AlejandroSobral/Proyecto-EA3/README.md

# UTN.FRBA - EA3 - 2021.
### Proyecto-EA3

- Gavegno, Sebastián
- Morandi, Pablo
- Scarini, Diego
- Sobral, Alejandro
