AlejandroSobral/Proyecto-EA3/Informe/Informe_Funcionamiento_Grupo_A_v1_notas.pdf

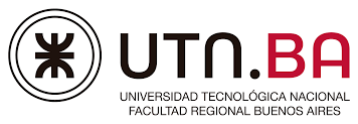
[picture p19: figure]

# Informe de Funcionamiento

## Proyecto: VCO (Voltage Controlled Oscillator)

## Materia: Electrónica Aplicada III

## Curso: R5053

## Grupo : A

## Integrantes del grupo:

### - Gavegno, Sebastián - Morandi, Pablo - Scarini, Juan Diego - Sobral, Alejandro

## Año : 2021

Electrónica Aplicada 3 - Informe de funcionamiento VCO (Voltage Controlled Oscillator) 2021

## Índice

- Índice | (pág. 2)
- Introducción | (pág. 3)
- Fundamentos teóricos del proyecto | (pág. 4)
- Cálculos y verificaciones | (pág. 8)
- Conclusiones | (pág. 22)
- Bibliografía | (pág. 23)

## Introducción:

La presentación de este informe de funcionamiento tiene como objetivo dar a conocer los fundamentos teóricos del funcionamiento del circuito, y sus posibles aplicaciones. El trabajo consiste en armar un circuito oscilador con FOL = 900 Mhz; utilizando un circuito integrado MAX2620. Las aplicaciones típicas del mismo abarcan telefonía celular, diversas aplicaciones en equipamientos de comunicaciones, entre otros.

## Fundamentos teóricos del proyecto

Para explicar el funcionamiento teórico del oscilador, comenzaremos con una analogía.
Es posible asimilar un oscilador a un circuito RLC paralelo. Para explicarlo, calculamos la respuesta libre del circuito en cuestión:

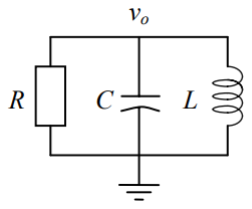
[picture p20: figure]

Si resolvemos la ecuación característica asociada, encontramos el valor de sus raíces como:

De donde podemos obtener que la condición para oscilación que estamos buscando, resulta cuando:

Del resultado anterior se deduce que un oscilador puede entenderse como un circuito LC asociado con una resistencia negativa. Al menos para entenderlo como condición necesaria de arranque. Dicha resistencia es necesaria para compensar la energía disipada en las resistencias parásitas del condensador y la bobina. Si fuera un circuito con Q ->∞, oscilaría a la frecuencia natural del par LC, y arrancaría por ruido.

Para lograr la mencionada condición de arranque, se plantea el la siguiente situación:

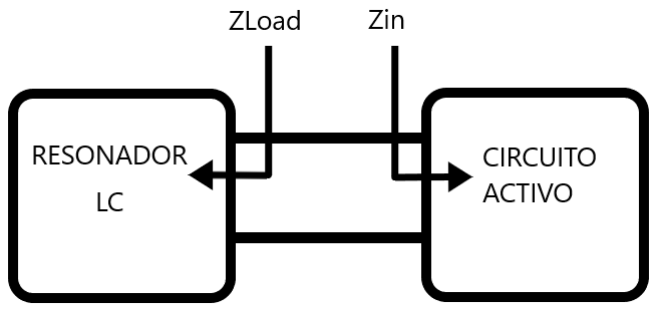
[picture p21: figure]

Dos bloques, uno determina la frecuencia, el resonador tanque LC y el otro es el circuito activo que mantiene la amplitud, mediante una resistencia negativa. Para entender este modelo suponemos que el resonador es un simple tanque junto con sus resistencias parásitas. Además, sabemos que el tanque por sí solo no puede oscilar indefinidamente porque una parte de la energía almacenada es disipada en la resistencia parásita en cada ciclo. La idea es que una red activa genere una impedancia negativa de la misma magnitud (de la misma magnitud en régmen) de la resistencia parásita. De manera resumida, se puede decir que la energía perdida por la resistencia parásita es restablecida por el circuito activo en cada ciclo, permitiendo una oscilación estable. Este modelo es llamado modelo de resistencia negativa porque la energía restaurada puede ser vista como una resistencia negativa que compensa la resistencia parásita del circuito tanque.

Un ejemplo de circuito que implementa este modelo, es la topología Colpitt common colector que figura a continuación, muy utilizada para VCO’s:

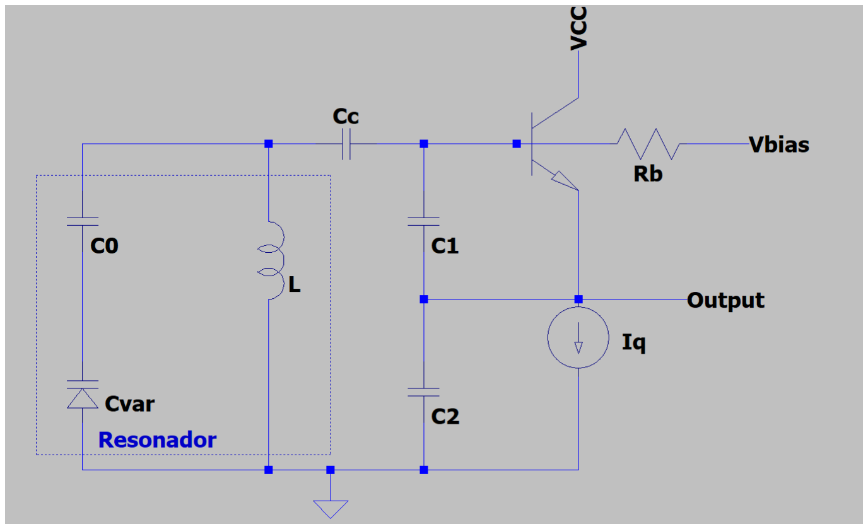
[picture p22: figure]

Este es el tipo de oscilador que el MAX2620 emplea, según la hoja de datos:

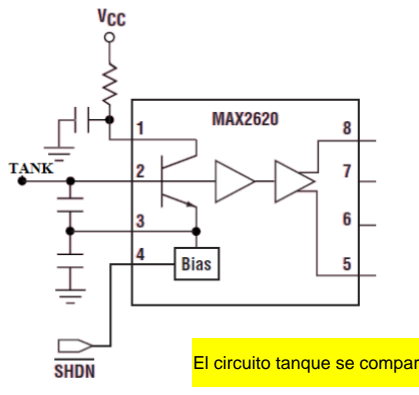
[picture p23: figure]

El circuito tanque es un circuito resonante paralelo que controla la frecuencia de oscilación variando el capacitor Cvar, para este caso.

Se pueden utilizar diodos varactores en el circuito resonante para crear un oscilador controlado por tensión (VCO).

El oscilador es en general un lazo amplificador realimentado, y las expresiones para obtener las frecuencias exactas se obtienen de las impedancias del modelo. Desde este punto de vista se plantea el modelo con una impedancia negativa y un acople que la elimina, esto se ve en la figura:

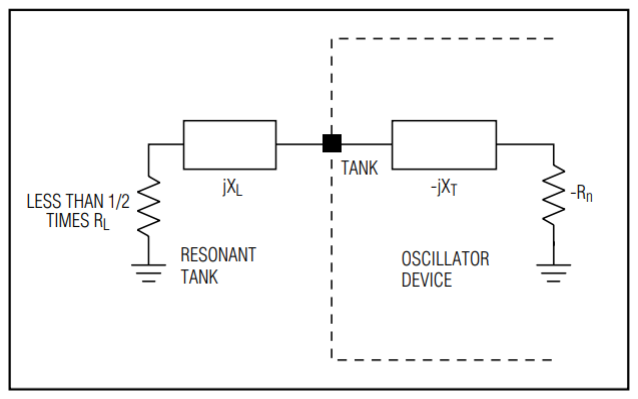
[picture p24: figure]

Para que el circuito oscile a la frecuencia deseada, el circuito tanque resonante conectado a TANK debe tener una componente real positiva que sea como máximo la mitad de la magnitud de la parte real negativa del dispositivo oscilador, para asegurar el correcto funcionamiento; así como una componente reactiva de signo contrario a la componente reactiva del dispositivo oscilador.

Manteniendo la componente real del circuito del tanque resonante por debajo de la mitad de la magnitud de la componente real negativa, se garantizan las oscilaciones de forma continua, según explica el fabricante en la hoja de datos.
Después de la puesta en marcha, la resistencia negativa del oscilador disminuye, principalmente debido a la compresión de la ganancia, y alcanza el equilibrio con el componente real (las pérdidas del circuito) en el circuito del tanque resonante. Para lograr un circuito sintonizable, (por ejemplo, mediante el uso de un diodo varactor), el oscilador debe mostrar resistencia negativa en el rango de sintonización deseado.

Se debe tener en cuenta que los componentes de montaje superficial también presentan capacitancias, inductancias y resistencias parásitas, y que esto afecta la sintonización en la frecuencia de interés. El varactor y la bobina presentan circuitos equivalentes suministrados por los fabricantes.

A continuación un posible circuito equivalente con todos los parámetros físicos representados:

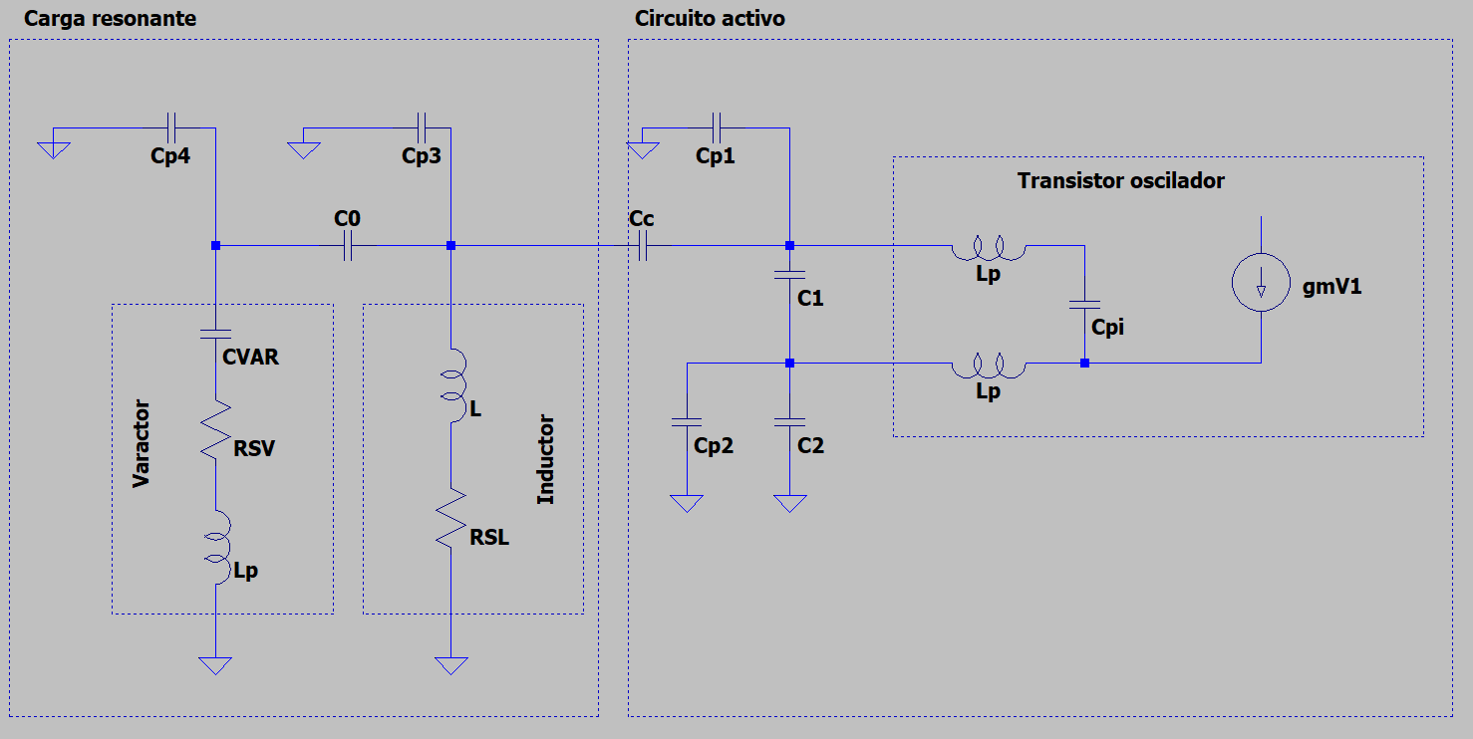
[picture p25: figure]

Aquí se ven el circuito del tanque y el circuito activo.

La reactancia presentada por el varactor a la frecuencia de trabajo, es prácticamente capacitiva. Es por esto que se adopta el modelo sin Lp asociada. Lo mismo sucede con el inductor, y finalmente se considera un inductor solo con una resistencia asociada.

## Cálculos y verificaciones

La resistencia negativa del pin TANK del MAX2620 puede optimizarse a la frecuencia deseada del oscilador mediante la selección adecuada de los condensadores de retroalimentación C3 y C4. Con estos dos condensadores se debe obtener una Rn (que es la resistencia negativa que se ve al mirar la impedancia de entrada MAX2620), la parte imaginaria debe mostrar un comportamiento capacitivo

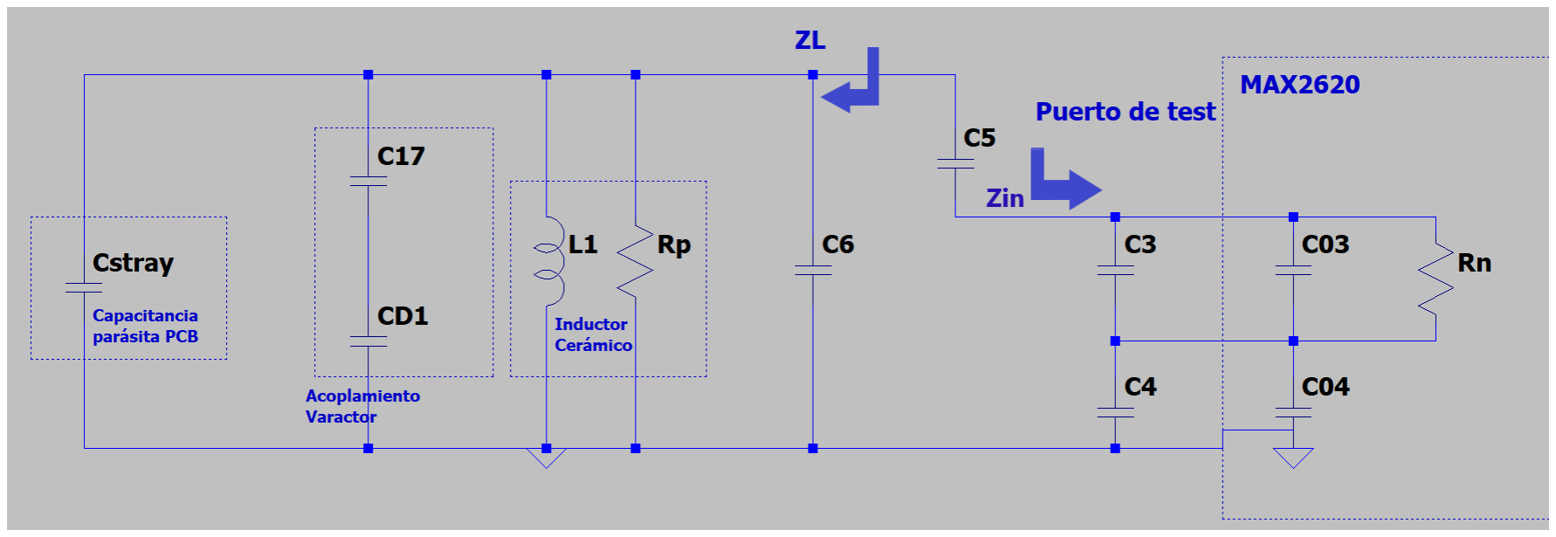
[picture p26: figure]

Se procede a hacer el cálculo de los dispositivos a usar, se tiene para la impedancia de entrada según el fabricante se tiene el siguiente circuito:

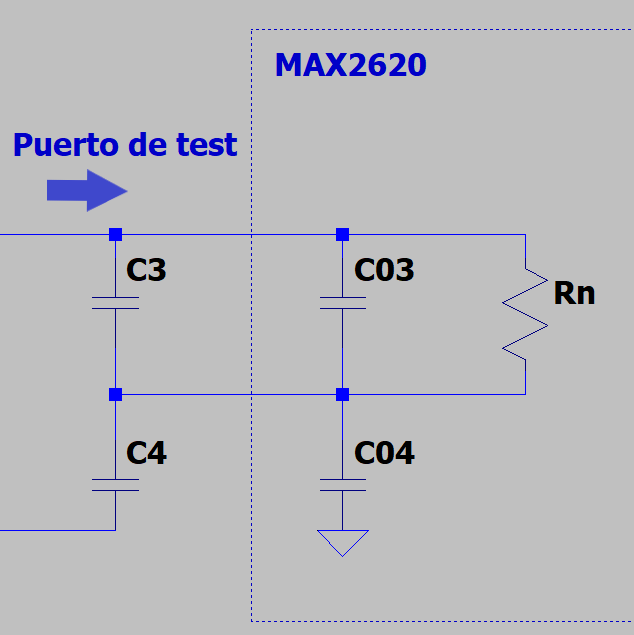
[picture p27: figure]

Si se tiene que las ecuaciones que determinan el valor de Rn donde esta es la impedancia real negativa, establecida por los condensadores C3 y C4 es aproximadamente:

donde gm = 18mS, por hoja de datos.

El valor obtenido de Rn para valores típicos y a f = 900Mhz

C03 = 2.4pF
C04 = 2.4pF
C3 = 2.7pF
C4 = 1pF
Rn = 32.4623 Ω

Si medimos Zin equivalente en el test port, obtenemos:

Zin = (-17 - j16 )Ω = 23.51Ωe^-137º

Si mido ZLoad desde el MAX2620, obtengo:

ZLoad = (10,74 + j87,25) Ω = 87,91 e^82º

Se comprueba la relación pedida por el fabricante para la f buscada:

RLoad < 1/2 |Rn|

10,74 < 11,755, por lo que el sistema se mantendrá oscilando.

Se calcula entonces la capacitancia que se necesita del varactor, buscando la frecuencia y fijando el valor de la bobina.

Los valores típicos seleccionados para 900Mhz según el fabricante son:

L1 = 5nH ±10%
Q = 140 Calculate:
Rp = Q × 2π × f × L1

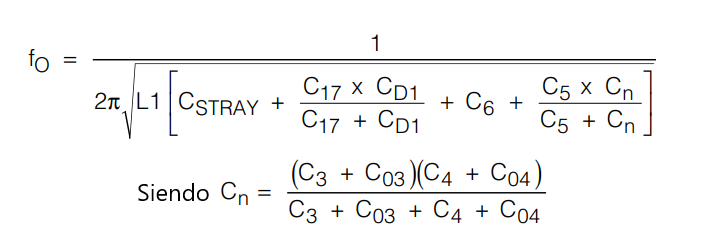
[picture p28: figure]

Utilizando la ecuación 1, se obtiene la capacidad del varactor (CD1). CD1 es la capacidad del varactor cuando el voltaje aplicado al varactor está aproximadamente a la mitad de la alimentación (el centro del rango de capacitancia del varactor).
Se plantean los siguientes valores típicos:
CSTRAY = 2,7pF, C17 = 1,5pF, C6 = 1,5pF, C5 = 1,5pF, C03 = 2,4pF, C04 = 2,4pF, C3 = 2,7pF y C4 = 1pF. El valor de CSTRAY se basa en el valir aproximado obtenido del kit MAX2620 EV. Los valores de C3 y C4 se eligen para minimizar Rn y no cargar el circuito resonante con una capacitancia excesiva. C03 y C04 son condensadores parásitos.

El rango de capacitancia del varactor debe permitir el rango de sintonía deseado. En todo el rango de frecuencia de sintonía, debe asegurarse que Rs < 1/2 Rn.
Se constata entonces, que para los valores obtenidos de CD1 el componente seleccionado como varactor es el correcto:

Se calcula utilizando un script de Python:

https://github.com/AlejandroSobral/Proyecto-EA3/blob/main/Pyhton/Calculos%20VCO.py

Frecuencia buscada: 900 M
Rp: 3.95841 k
Cn : 2.04 p
Valor exacto del varactor para 900Mhz: 5.75776653412866e-12
Con este valor, se evalúa el varactor correspondiente.
Se calcula el valor de la resistencia que presenta el puerto de entrada del tanque del MAX |Rn| : 32.4623
Frecuencia resultante recalculada con CD1 : 900.000000000001 M

Dado que no tenemos un modelo para simulador de un integrado MAX2620, explicaremos teóricamente y simularemos un circuito de funcionamiento similar, pero explicado a través del modelo de cuadripolos.

## Condición de arranque y frecuencia de oscilación:

Otra forma de analizar el funcionamiento del circuito, es mediante el análisis del modelo de cuadripolo y las condiciones de Barkhausen:

Para obtener la condición de arranque y la frecuencia de oscilación, se aplica:

∠(A. β) = 0

|A. β| > 1
La ganancia de lazo, A. β, es independiente del punto en el que se abra el lazo para su cálculo.

Aplicando el criterio matricial, obtenemos las ecuaciones del cuadripolo A y β, y así obtener la matriz admitancia total del sistema.

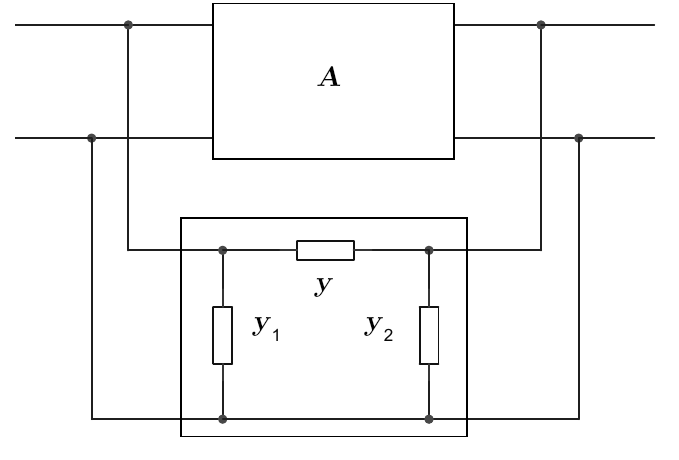
[picture p29: figure]

Diagrama en bloque - Parámetros Y

Dado que es un oscilador, asumimos que la carga es parte del cuadripolo A. Si el determinante de la matriz admitancia total es igual a cero (ΔY = 0) el sistema es indeterminado y admite infinitas soluciones.

Para obtener la condición de arranque y la frecuencia de oscilación usamos un modelo de pequeña señal, para simplificar el análisis,

Despejando Y21A:

donde:

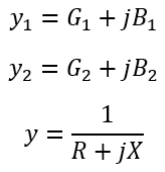
[picture p30: figure]
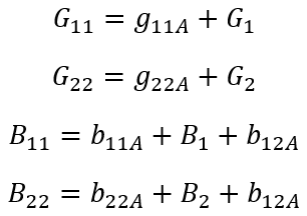
[picture p31: figure]

La condición de arranque la obtenemos a partir de calcular la parte real de la fórmula de ΔY.

La frecuencia de oscilación la obtenemos a partir de calcular la parte imaginaria de ΔY.

Para nuestro análisis utilizaremos una red Colpitts. Esta red está compuesta por un inductor en serie, ubicado entre dos capacitores en derivación.

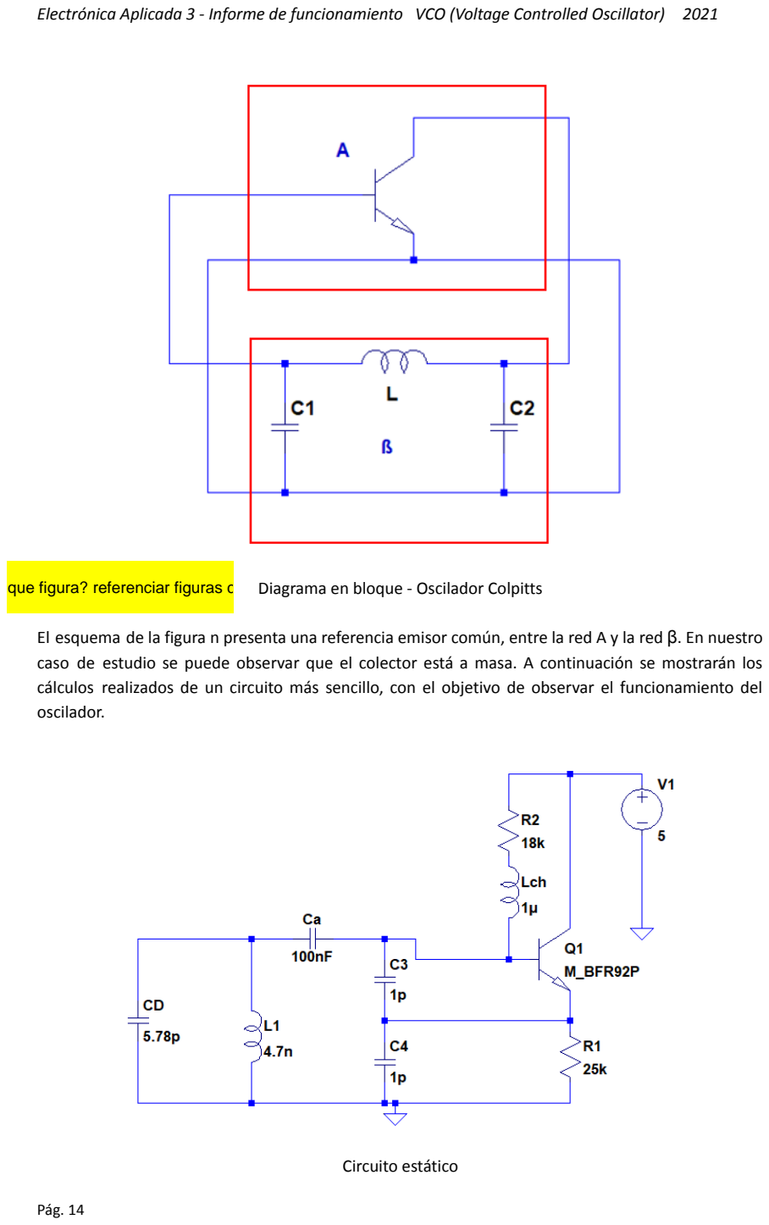
[picture p32: page 14]

Diagrama en bloque - Oscilador Colpitts

El esquema de la figura n presenta una referencia emisor común, entre la red A y la red β. En nuestro caso de estudio se puede observar que el colector está a masa. A continuación se mostrarán los cálculos realizados de un circuito más sencillo, con el objetivo de observar el funcionamiento del oscilador.

Circuito estático

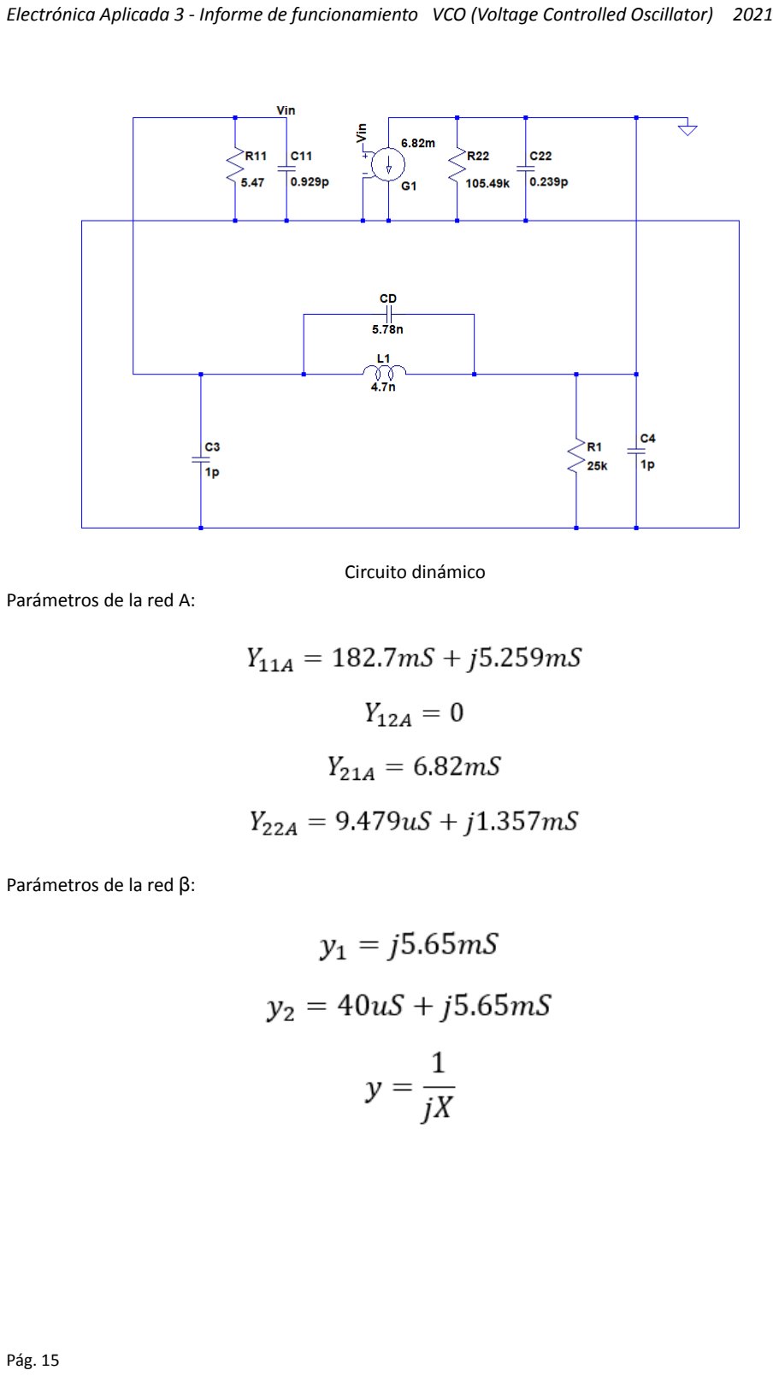
[picture p33: page 15]

Circuito dinámico
Parámetros de la red A:

Parámetros de la red β:

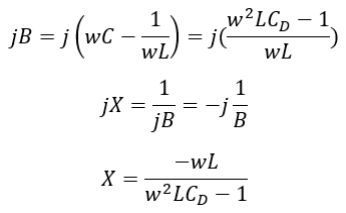
[picture p34: figure]

Busco el valor de L1 a través de la condición de oscilación para un valor de CD prefijado sacado por los valores del fabricante.

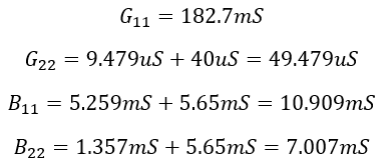
[picture p35: figure]
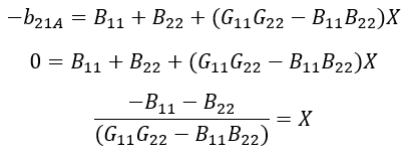
[picture p36: figure]

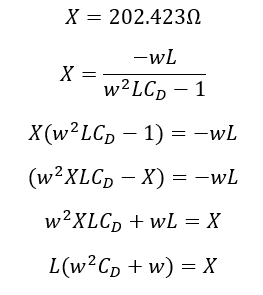
[picture p37: figure]
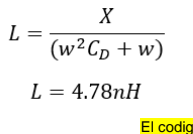
[picture p38: figure]

Para calcular los resultados exactos se utilizó Python, se disponibiliza el código aquí:

https://github.com/AlejandroSobral/Proyecto-EA3/blob/main/Python/Calculos%20Collpits.py

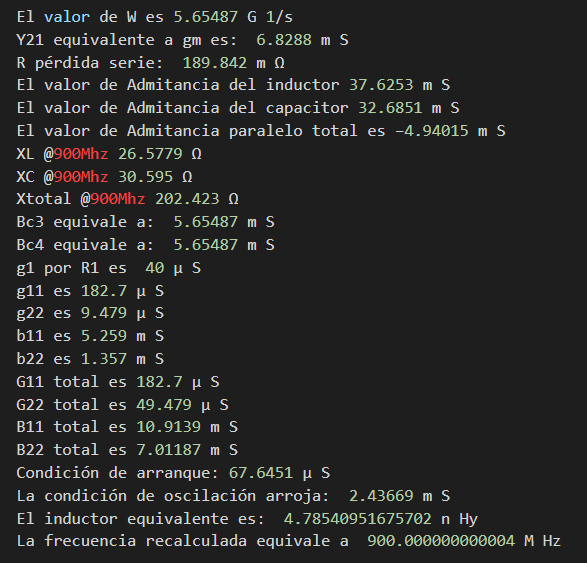
[picture p39: figure]

## Mediciones con LTSpice:

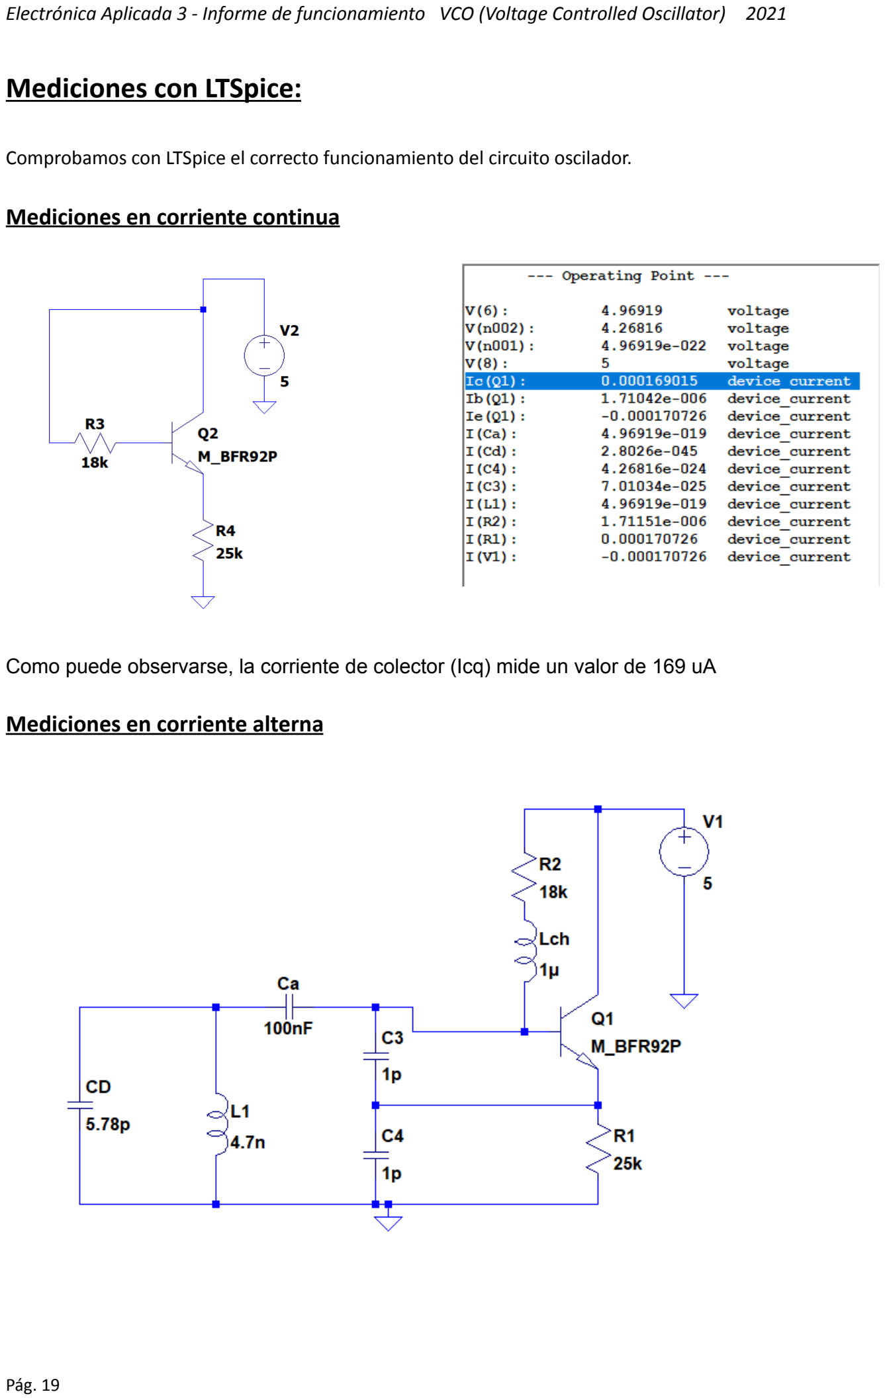
[picture p40: page 19]

Comprobamos con LTSpice el correcto funcionamiento del circuito oscilador.

### Mediciones en corriente continua

### Como puede observarse, la corriente de colector (Icq) mide un valor de 169 uA

### Mediciones en corriente alterna

## Tensión de salida del oscilador sobre la base del transistor

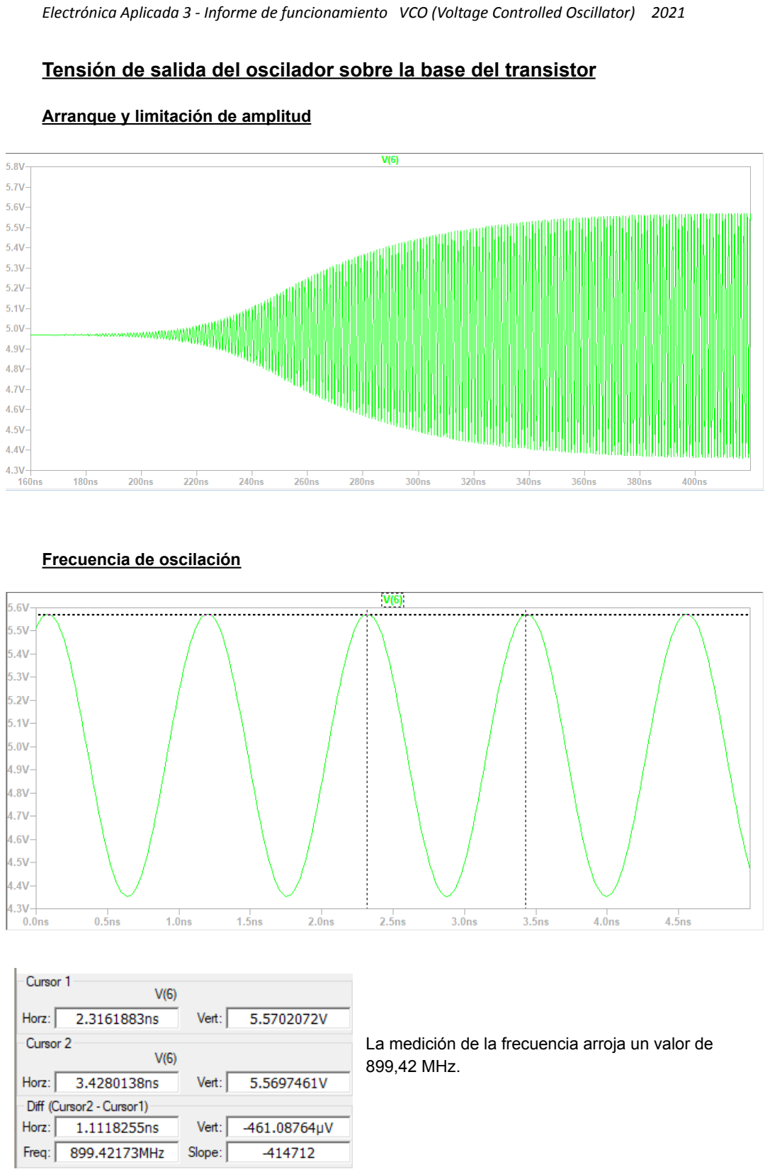
[picture p41: page 20]

### Arranque y limitación de amplitud

### Frecuencia de oscilación

### La medición de la frecuencia arroja un valor de

899,42 MHz.

### Análisis espectral

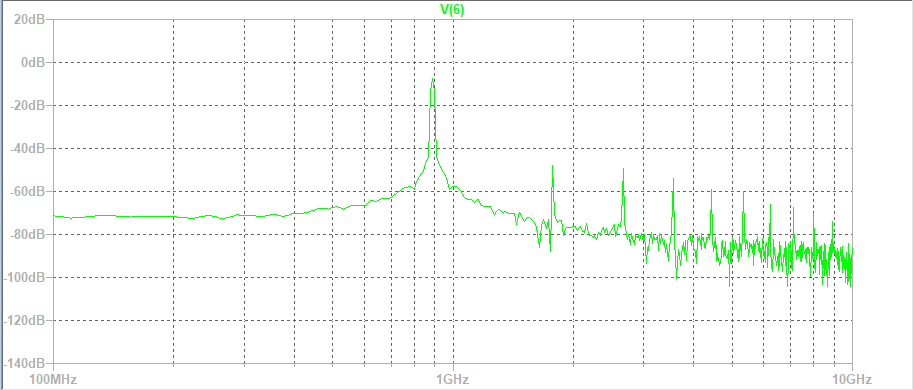
[picture p42: figure]

### Podemos observar que en 2fo, 3fo… aparecen frecuencias armónicas producto del

oscilador. Aparecen por debajo de los -40dB pero sería conveniente filtrar estas frecuencias espurias para asegurar el buen funcionamiento.

## Conclusiones

Podemos concluir que cualquiera sea el circuito o el modelo adoptado, los principios fundamentales del fenómeno oscilatorio radican en la misma idea base. Un par de elementos pasivos, mediante sus frecuencias naturales de oscilación, combinados con los valores de de susceptancia de entrada y salida del dispositivo activo, determinarán la frecuencia de oscilación del circuito.
Por otra parte, debe existir una transconductancia, exclusiva del dispositivo activo, que mantiene la oscilación en el tiempo, y a la vez garantiza la condición de arranque.

El fabricante del MAX2620 explica el funcionamiento a través de un modelo de dos terminales, considerando resistencias negativas y positivas en puntos importantes del circuito, entendiendo que éstas garantizarán condición de arranque y estabilidad temporal. El enfoque de cuadripolos visto durante el año es similar, pero con cuatro terminales en lugar de dos. Conceptualmente, son equivalentes.

Otra interpretación del fenómeno, más matemática, podría indicar que antes del arranque los polos del circuito se encuentran en el semiplano derecho, y que pasado el transitorio, el dispositivo activo los mantiene sobre el eje imaginario.

Concluímos que la realización del trabajo práctico ayudó a fijar los conceptos teóricos analizados durante el año lectivo. Permitiendo simular un caso real de aplicación, ayudando a los alumnos a comprender de forma integral las necesidades que se presentan al desarrollar proyectos de esta índole.

## Bibliografía

O’CONNOR C. (2000). Develop A Trimless Voltage-Controlled Oscillator. California, Estados Unidos .Maxim Integrated Products. https://www.ladyada.net/techproj/freshair/doc/VCO%20design/maxim%20trimless%20vco%20desig n.pdf (https://www.ladyada.net/techproj/freshair/doc/VCO%20design/maxim%20trimless%20vco%20design.pdf)

FACULTAD DE INGENIERÍA UNLP (2021). Osciladores Sinusoidales. La Plata, Argentina. Universidad Nacional de La Plata
https://catedra.ing.unlp.edu.ar/electrotecnia/electronicos2/download/Apuntes/Teo4.1-OsciladoresSi n.pdf (https://catedra.ing.unlp.edu.ar/electrotecnia/electronicos2/download/Apuntes/Teo4.1-OsciladoresSin.pdf)

Apuntes de la cátedra.
