AlejandroSobral/Proyecto-EA3/Informe/Informe_Practico_Grupo_A_v1_notas.pdf

# Informe Práctico

## Proyecto: VCO (Voltage Controlled Oscillator)

## Materia: Electrónica Aplicada III

## Curso: R5053

## Grupo : A

## Integrantes del grupo:

### - Gavegno, Sebastián - Morandi, Pablo - Scarini, Juan Diego - Sobral, Alejandro

## Año :2021

Electrónica Aplicada 3 - Informe Práctico | VCO (Voltage Controlled Oscillator) | 2021

## Índice

- Introducción | (pág. 3)
- Diseño y consideraciones prácticas | (pág. 3)
- Layout del PCB | (pág. 7)
- Lista de componentes (BOM) | (pág. 11)
- Mediciones y verificaciones | (pág. 13)
- Conclusiones | (pág. 14)
- Bibliografía | (pág. 15)

## Introducción

En el presente informe, se busca explicar el proceso de diseño y desarrollo de un oscilador controlado por tensión (“Voltage Controlled Oscillator”, por sus siglas en inglés, VCO) de 900Mhz utilizando el integrado MAX2620 de MAXIM.
Este diseño incluye un circuito tanque basado en un varactor que permite al VCO sintonizar una banda de 30MHz en el rango de frecuencia de 900MHz. Las salidas utilizan conectores de 50Ω SMA. Se tiene un puerto de prueba que facilita la caracterización completa del puerto del tanque MAX2620, lo que permite diseñar resonadores para rangos de frecuencia distintos a los suministrados.

## Diseño y consideraciones prácticas

## Selección del regulador de baja caída (Low Dropout Voltage - LDO)

Es importante tener en cuenta para la selección del regulador que alimenta al MAX2620:

➔ Debe ser de baja caída (LDO) para tener un mayor rango de tensión de entrada ➔ PSRR (Power Supply Rejection Ratio) > 40 dB
➔ Output Noise < 50uV RMS

Considerando estas pautas de diseño a cumplir, elegimos el integrado ADP7104 que es un LDO de bajo ruido (Low Noise CMOS LDO) en su versión fija de Vout = 3.3V.

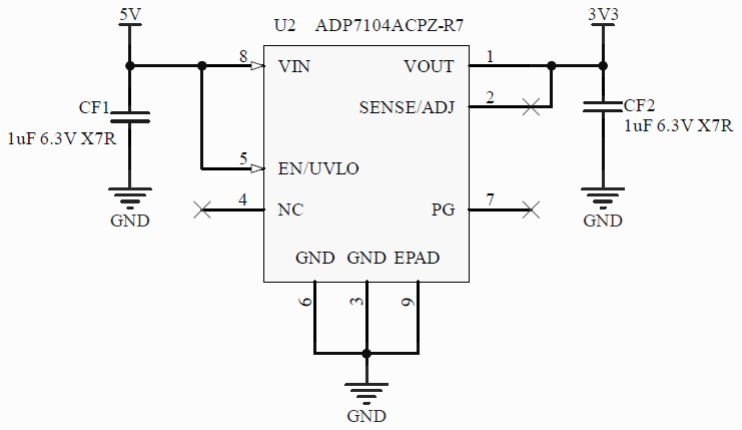
[picture p43: figure]

Este integrado fue diseñado para aplicaciones sensibles al ruido como por ejemplo:

- Circuitos de ADC y DAC
- Amplificadores de precisión
- Osciladores de alta frecuencia
- Clocks
- PLLs

El MAX2620 se alimenta con una tensión entre +2.7V y +5.25V. Por lo tanto, adoptamos una tensión de alimentación de 3.3V y analizamos la caída que tendrá el ADP7104 para el consumo del oscilador (Typical = 9mA).

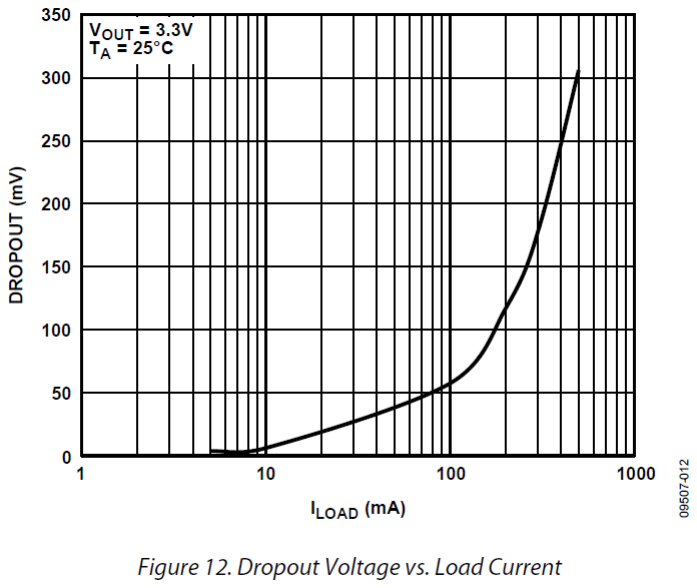
[picture p44: figure]

Como puede observarse, para una
corriente | de | carga | de | 9mA
aproximadamente caen menos de 20mV en el regulador estando dentro de los objetivos planteados para el diseño.

Analizamos ahora el PSRR. Hay 2 escenarios posibles: fuente de alimentación Switching (Conmutada) o lineal. Para ambos casos, analizamos este parámetro sobre la curva que nos brinda el fabricante:

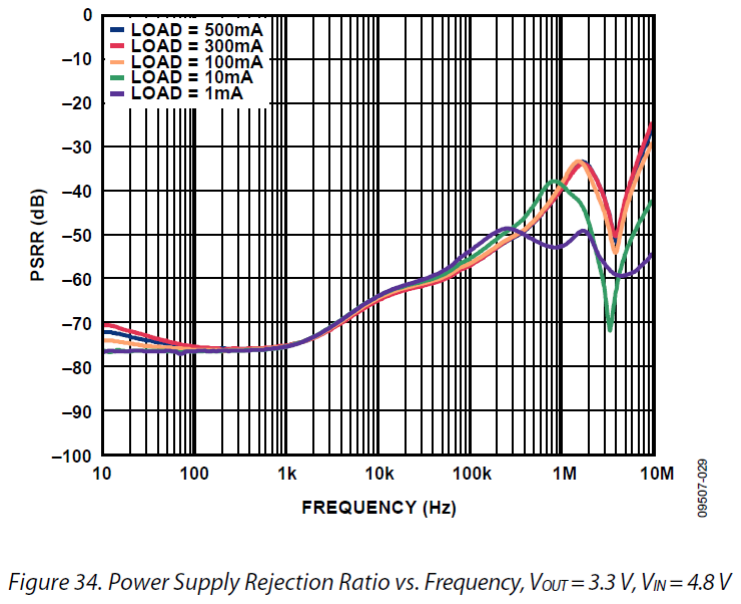
[picture p45: figure]

Si utilizamos una fuente lineal, vemos que para nuestro caso (MAX2620 consume aprox. 9mA) tendremos una atenuación muy alta de ripple en la salida (-75 dB aprox).

Ahora bien, si alimentamos al LDO con una fuente conmutada, vemos que cae la atenuación de PSSR a -60dB aprox. asumiendo que la frecuencia de conmutación de la switching es de 50kHz.

En ambos casos se cumple con el objetivo de diseño, aunque la primera opción es la mejor.

Finalmente, nos queda por analizar el ruido de salida (Output Noise) para la corriente que consume el MAX2620 qué es la carga para el LDO, siendo esta de aprox. 9mA y la tensión de salida de 3.3V

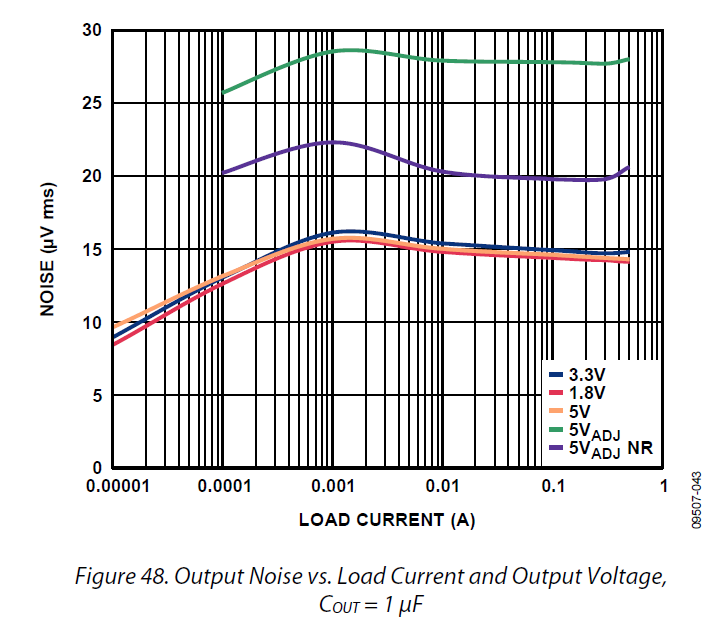
[picture p46: figure]

Del gráfico, vemos que para una carga de 9mA y una Vout = 3.3V se producirá un valor de ruido de aprox. 15 uV RMS, cumpliendo con nuestros objetivos de diseño.

## Seleccion del resonador

El resonador es fundamental para el rendimiento del VCO. Para maximizar el rendimiento se utilizan componentes de Q elevado. El resonador ha sido diseñado para trabajar a 900MHz.

El fabricante utiliza el resonador SR8800LPQ1357BY marca TransTech. Utilizado para aplicaciones de bajo ruido y osciladores controlados por tensión (VCO).

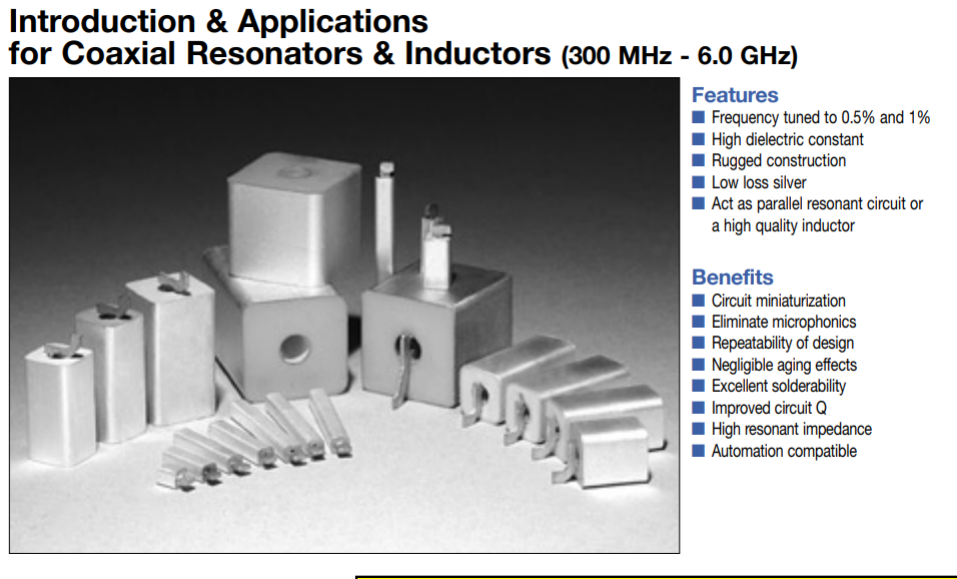
[picture p47: figure]

Al momento de diseñar la placa se deben tener en cuenta los elementos parásitos. Para esto, se debe medir la impedancia de entrada TANK con los capacitores C3 y C4 sin el resonador.

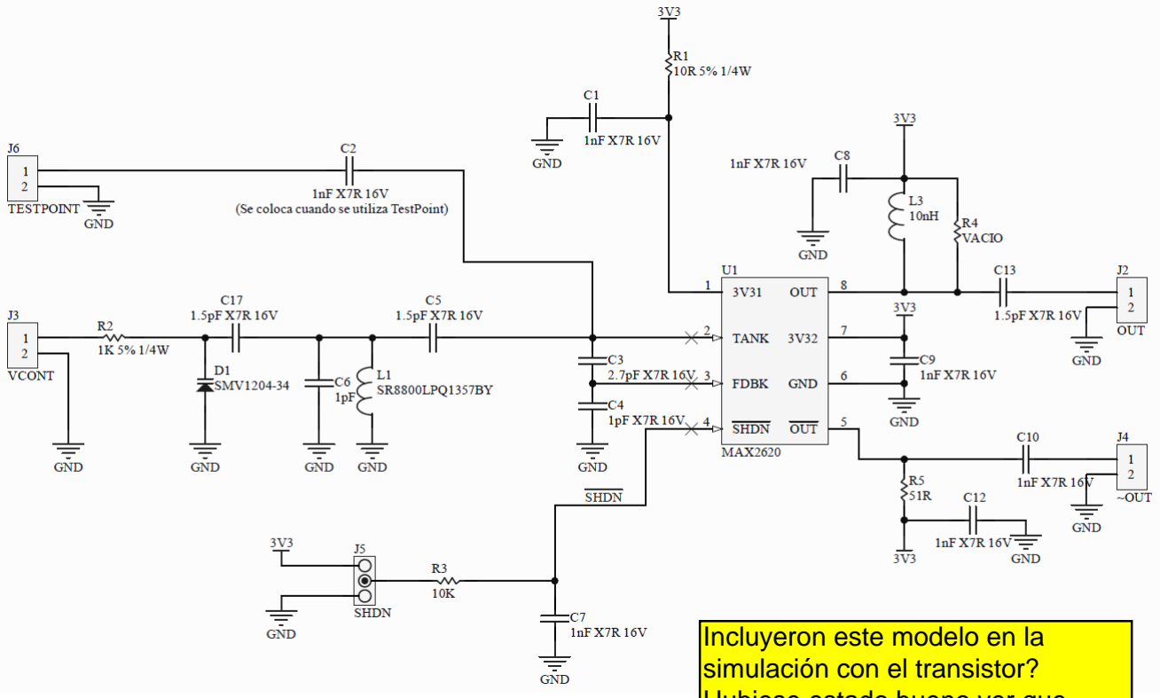
[picture p48: figure]

Para facilitar esta medición se quita C5 y se coloca en C2 un capacitor de 1nF. La medición en TEST PORT debe proporcionar una resistencia de entrada negativa y, por lo tanto, devolverá la ganancia cuando se mide S11 en un analizador de red vectorial. Configurando el analizador para que muestre 1/S11, este nos presenta los datos de impedancia de entrada deseada para proporcionar la retroalimentación para oscilar a la frecuencia deseada.

Para que el circuito oscilador se vea poco afectado por las pérdidas en el varactor, el valor de capacidad de C17 debe ser pequeño.

Para minimizar los efectos de los elementos parásitos, que pueden alterar el rendimiento del circuito, debe retirarse el plano de tierra alrededor y debajo de los componentes que forman el circuito resonante (C3-C6, C17, D1 y L1). Mantener las trazas de la placa de circuito impreso lo más cortas posible para minimizar la inductancia parásita. También se deben ubicar lo más cerca posible del MAX 2620, los capacitores C1, C7 y C9, con conexión directa al plano de tierra.

## Layout del PCB

## Esquemáticos

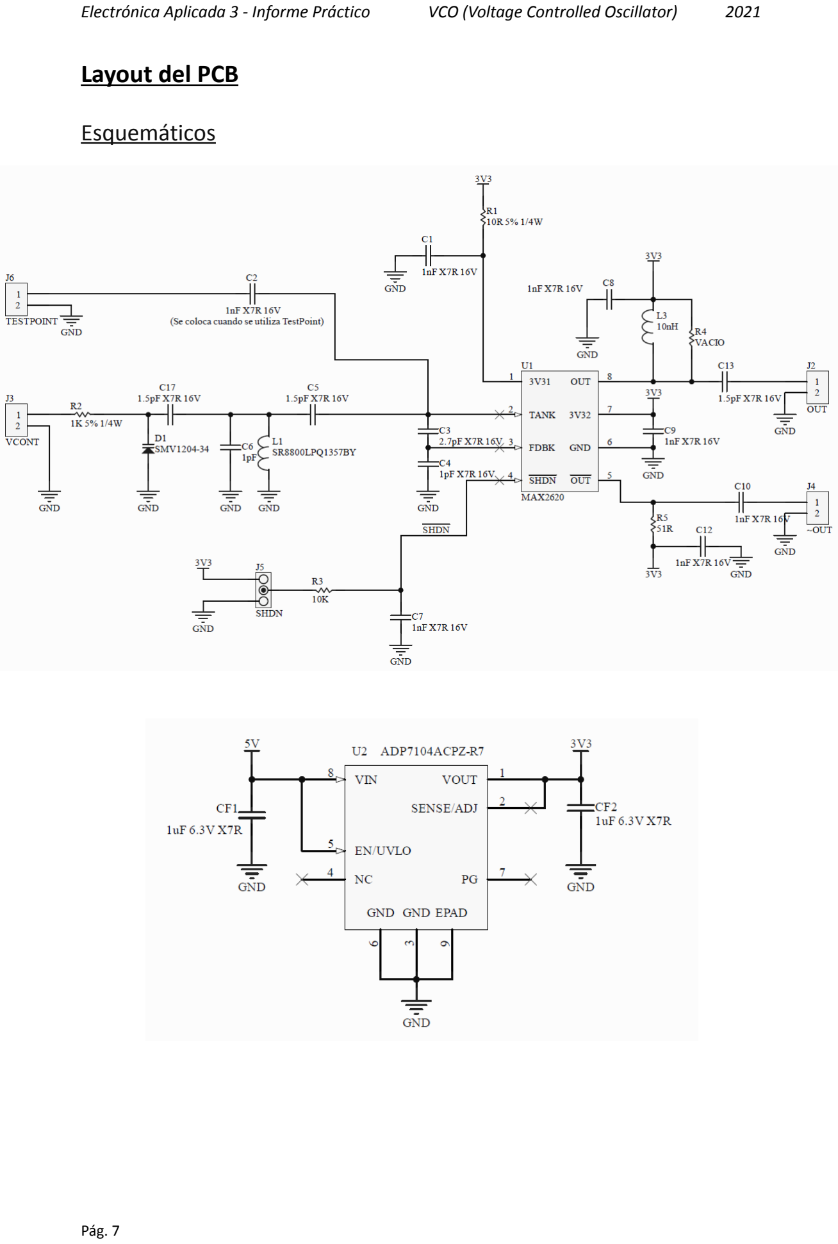
[picture p49: page 7]

## Placa de circuito impreso

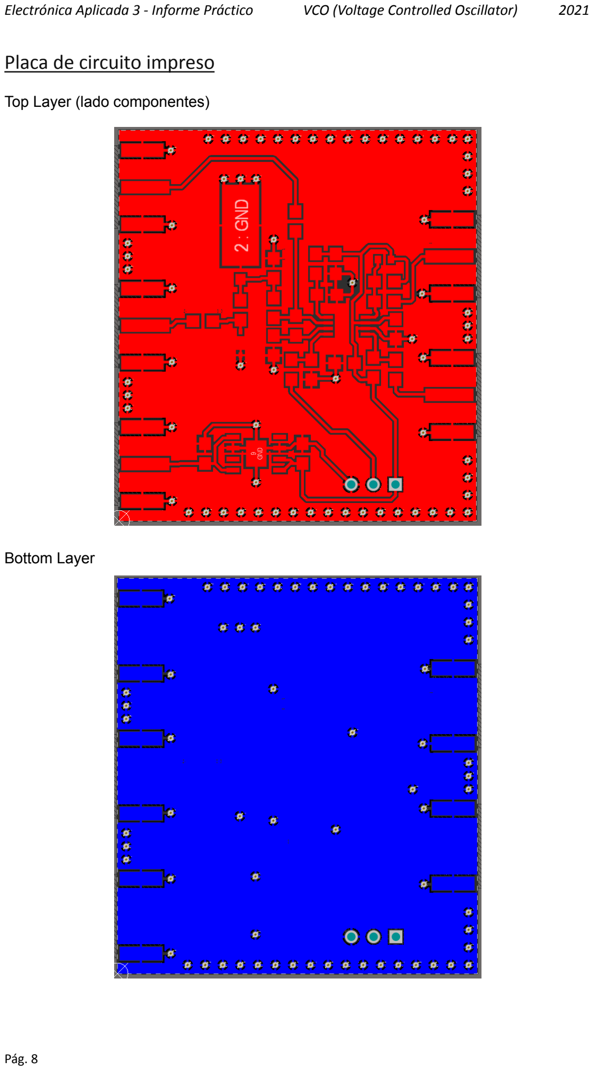
[picture p50: page 8]

### Top Layer (lado componentes)

### Bottom Layer

### Top Overlay (Serigrafía)

### PCB completo

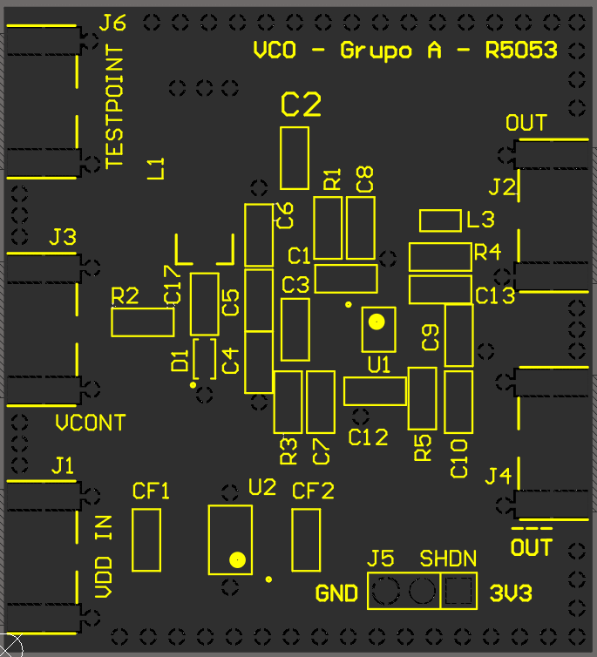
[picture p51: figure]

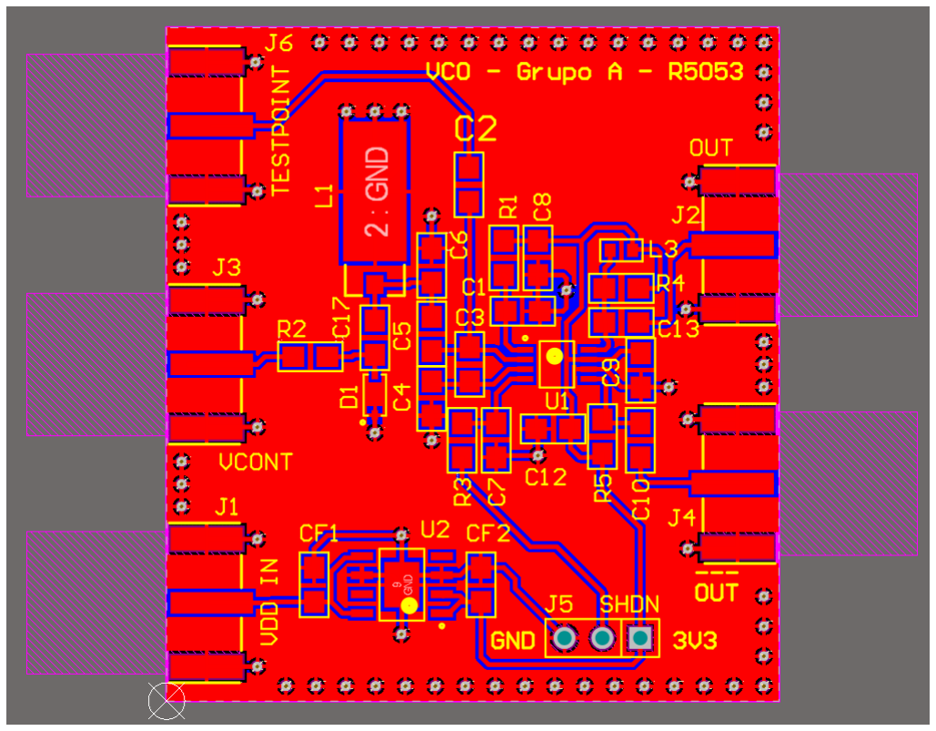
[picture p52: figure]

### Vistas 3D

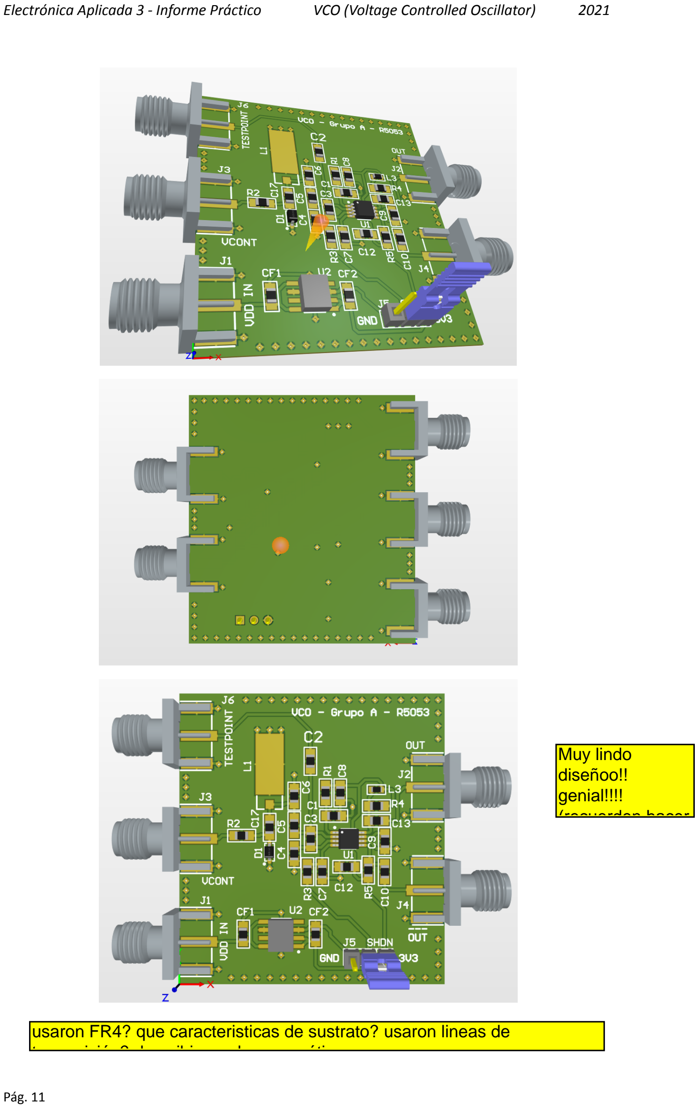
[picture p53: page 11]

## Lista de componentes (BOM)

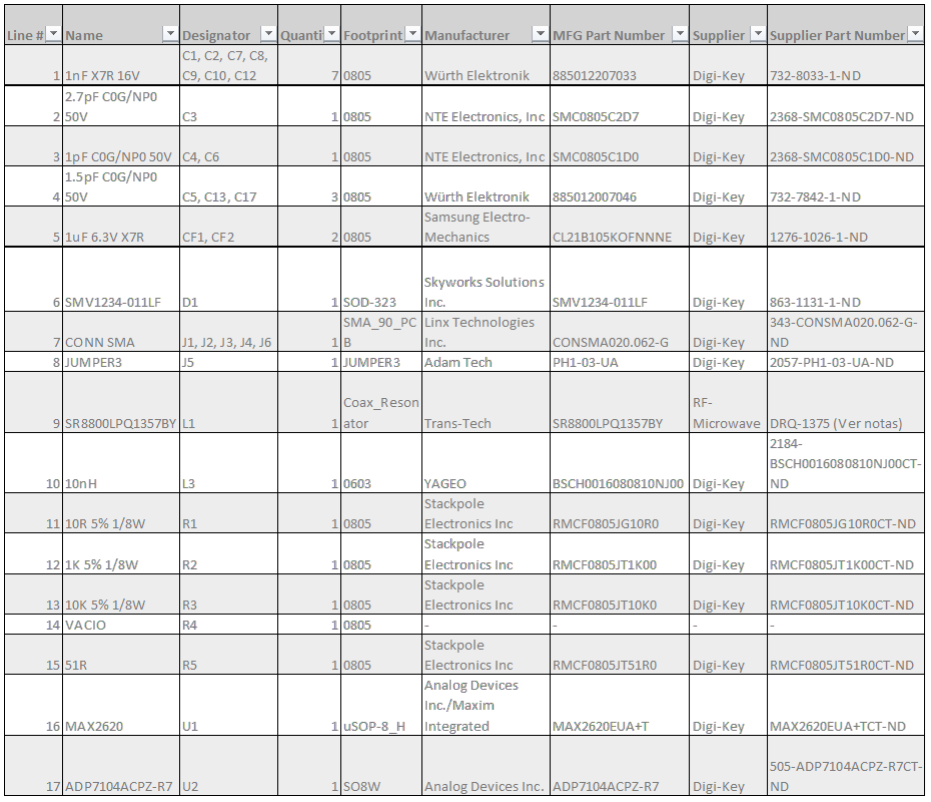
[picture p54: figure]

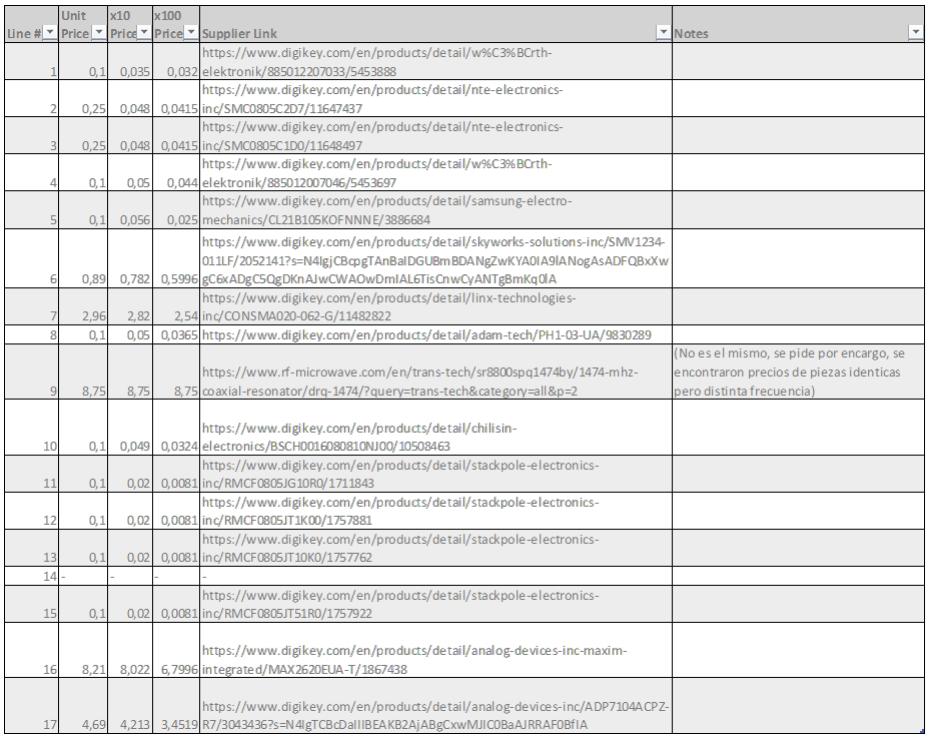
[picture p55: figure]

## Mediciones y verificaciones

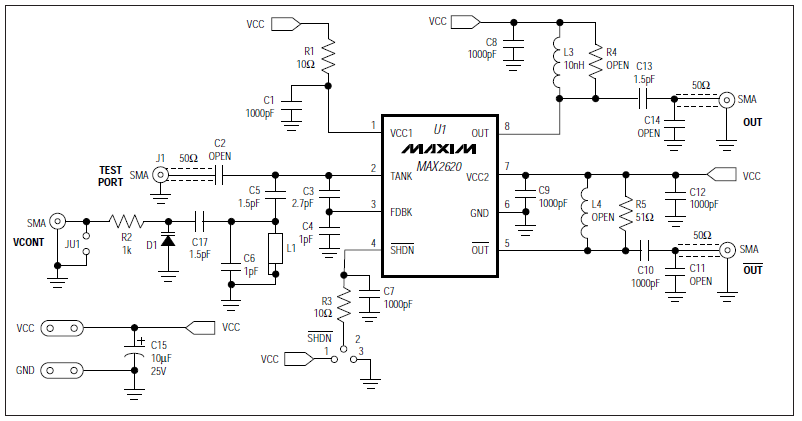
[picture p56: figure]

Para efectuar las mediciones utilizamos un analizador de espectro para el análisis de la señal. El módulo, se alimentará con una fuente de alimentación de bajo ruido capaz de suministrar +3V de CC para la entrada VCONT y a la entrada VCC la podemos alimentar con un rango de +2.7V a +5.25V de CC.
Para realizar la medición nos aseguramos de que la entrada SHDN esté a 3V3. Conectamos el analizador de espectro a la salida OUT.
Para el análisis de la señal de salida utilizamos el analizador de espectro conectado a la salida OUT. Si aplicamos una 1.5v a VCONT, la frecuencia de salida será de 900 MHz. Si variamos la tensión aplicada a VCONT entre 0 V y VCC la frecuencia del oscilador cambia.
Para minimizar el error de medición dejamos que el oscilador funcione por 5 minutos para que alcance la estabilidad térmica.
Para una mejor lectura del analizador de espectro debemos centrar a frecuencia fundamental y establecer un intervalo de frecuencia de 100 kHz.

## Conclusiones

Debido a la antigüedad de la bibliografía (EVK-MAX2620) algunos componentes no están disponibles actualmente, fueron reemplazados por su equivalente actual. Un caso es el del diodo varactor que fue reemplazado por el SMV1234, de la misma serie, pero en producción actual. Destacamos la dificultad de acceder a los datos del resonador coaxial, pero es debido a que el número de parte corresponde a una petición especial a la empresa Trans-Tech, hoy parte de Skyworks Solutions Inc. En la lista de materiales se seleccionó un resonador coaxial similar al requerido por el kit de evaluación del MAX2620.

Se utilizaron todos conectores SMA en el diseño del PCB, esto ayuda a conservar la inmunidad al ruido requerida para los ensayos prácticos. En el caso de ensamblar un frontend de RF es muy importante no tener fuentes de ruido en frecuencias elevadas. Esto fue un desafío ya que era importante seleccionar una fuente de energía adecuada para el VCO. Luego de una búsqueda por distintos fabricantes elegimos el ADP7104 por tener una muy buena regulación en carga, y una excelente aislación con sus 60db de PSRR.

Para facilitar el estudio del circuito integrado, se añadió un jumper de 3 posiciones para controlar el pin de SHUTDOWN del MAX2620, lo que permite evaluar su consumo cuando está encendido el oscilador y cuando el mismo se encuentra apagado. Esto es utilizado para estudiar el consumo de energía en estado de reposo, cuando no se está utilizando el oscilador controlable.

## Bibliografía

MAXIM (1998). MAX2620 Evaluation Kit. California, Estados Unidos. Maxim Integrated Products.
https://datasheets.maximintegrated.com/en/ds/MAX2620EVKIT.pdf

MAXIM (2002). 10MHz to 1050MHz Integrated RF Oscillator with Buffered Outputs - MAX2620. (2da Ed.). California, Estados Unidos. Maxim Integrated Products. https://datasheets.maximintegrated.com/en/ds/MAX2620.pdf

ANALOG DEVICES (2019). 20 V, 500 mA, Low Noise, CMOS LDO - ADP7102. (Rev. I). Norwood, Estados Unidos. Analog Devices, Inc. https://www.analog.com/media/en/technical-documentation/data-sheets/ADP7104.pdf
