AlejandroSobral/Proyecto-EA3/Python/source/900m.PNG

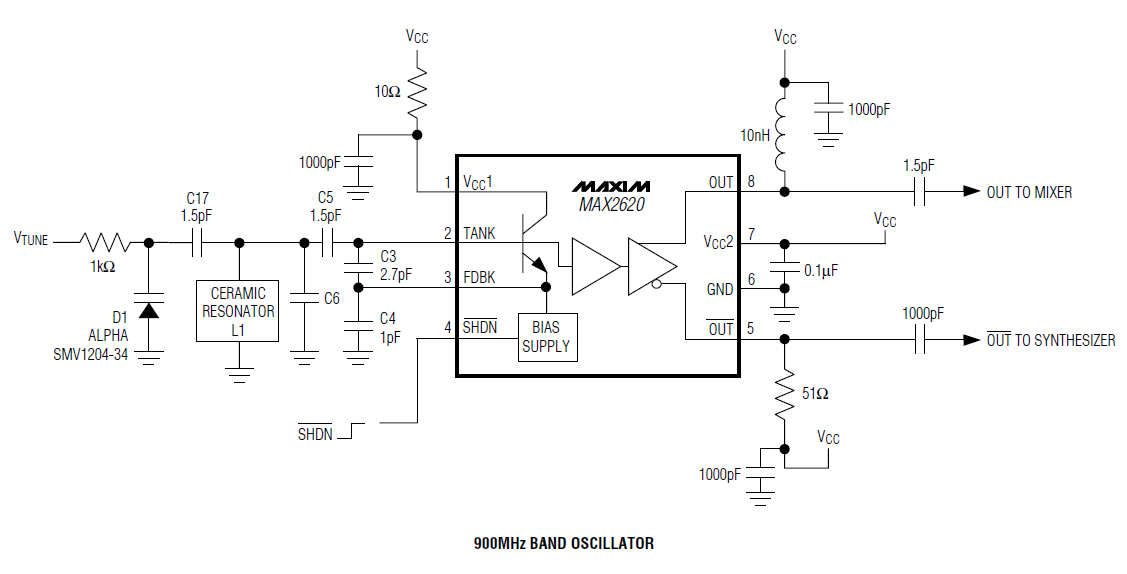
Python/source/900m.PNG
