AlejandroSobral/Proyecto-EA3/Python/source/Fo.PNG

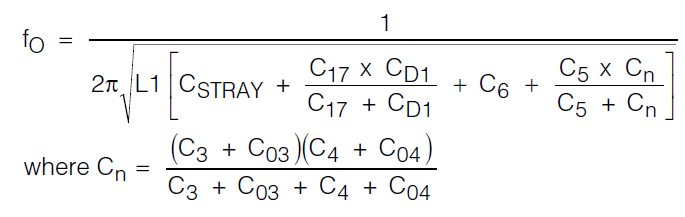
Python/source/Fo.PNG
