AlejandroSobral/Proyecto-EA3/Python/source/Varactor.png

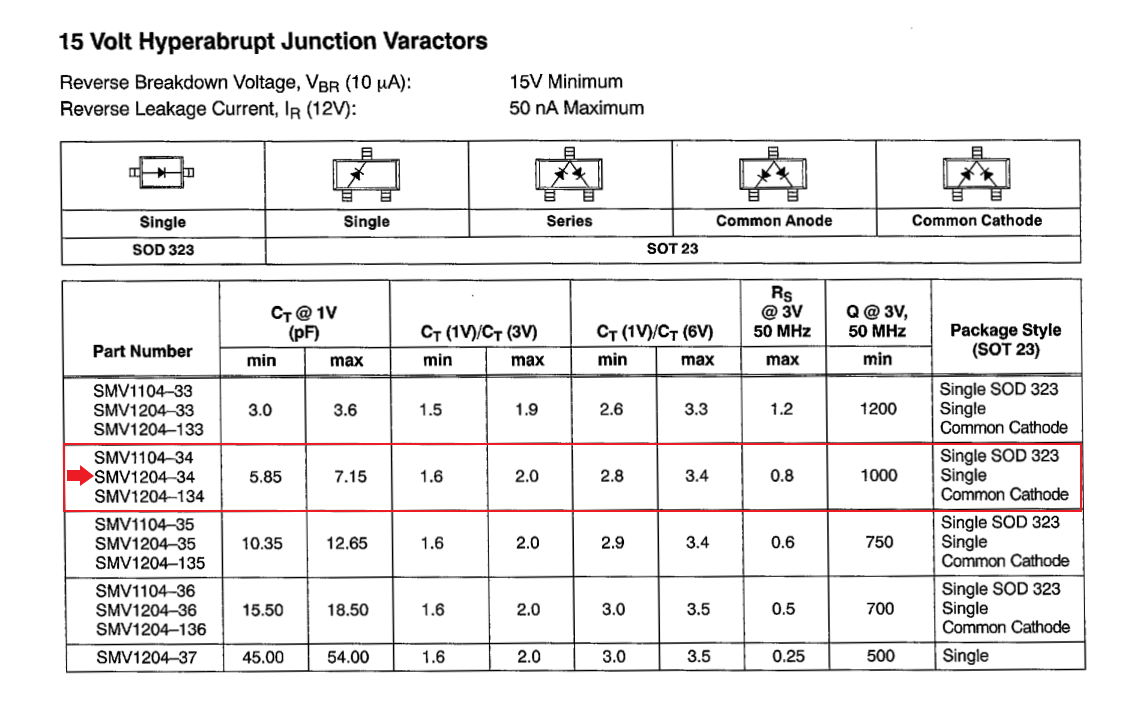
Python/source/Varactor.png
