AlejandroSobral/Proyecto-EA3/Spice/FotoInforme.asc

C0: cap
C1: cap
C2: cap
C3: cap; C0
C4: cap; Cp4
C5: cap; C1
C6: cap; C2
C7: cap; Cp3
C8: cap; CVAR
C9: cap; Cp1
C10: cap; C1
C11: cap; C2
C12: cap; Cp2
C13: cap; Cpi
Cc: cap
Cc: cap
Cres: cap
D1: varactor; Cvar
I1: current
I2: current; Iq
I3: current; gmV1
L1: ind
L2: ind; Lp
L3: ind
L4: ind; Lp
L5: ind; Lp
LRes: ind
Q1: npn
Q2: npn
R1: res; Rb
R2: res; RSV
R3: res; RSL
Named nets: VCC, 0, Output, Vbias
Tanque
Carga resonante
Circuito activo
Inductor
Varactor
Transistor oscilador
