AlejandroSobral/Proyecto-EA3/Spice/Modelo_eléctrico.asc

C3: cap; {C_3}
C03: cap; {C_03}
C4: cap; {C_4}
C04: cap; {C_04}
C5: cap; {C_5}
C6: cap; {C_6}
C17: cap; {C_17}
CD1: cap; {C_D1}
Cstray: cap; {C_stray}
L1: ind; {L_1}
Rn: res; {R_n}
Rp: res; {R_p}
Named nets: 0
.param C_stray = 2.7e-12
.param C_17= 1.5e-12
.param C_6 = 1.5e-12
.param C_5 = 1.5e-12
.param C_03 = 2.4e-12
.param C_04 = 2.4e-12
.param C_3 = 2.7e-12
.param C_4 = 1e-12
.param C_D1 = 5.75e-12
.param L_1 = 5e-9
.param R_n = -32
.param R_p = 3.95e3
.ac dec 10000 800e6 1000e6
Capacitancia
parásita PCB
Acoplamiento
Varactor
Inductor
Cerámico
MAX2620
Puerto de test
ZL
