AlejandroSobral/Proyecto-EA3/Spice/VCO Colpitt.asc

C1: cap; 100e-12
C2: cap; 68e-12
C3: cap; 100e-12
C4: cap; 100e-12
C5: cap; 10e-9
L1: ind; 100e-6
L2: ind; 1e-6
Q1: npn; BC547C
R1: res; 1e3
R2: res; 15e3
R3: res; 27e3
R4: res; 100
V1: voltage; 12
Named nets: OUT, 0
.tran 0 2e-6 0
