AlejandroSobral/Proyecto-EA3/(commit log)

2021-07-17 Agrego Python con calculos de Datasheet
2021-07-17 Script que calcula Cvaractor y recalcula F funcionando
2021-07-20 Agrego calculo de Rn
2021-07-22 Corrijo nombres de directorios
